aaronhyzhang/lasertrackinggimbal-ece445/vision/measurements/mpstesting.csv

frame_index | elapsed_s | detected | geometry_error | ball_diameter_m | imgsz | device_requested | device_actual | capture_ms | inference_ms | display_ms | loop_ms | fps | x1_px | y1_px | x2_px | y2_px | confidence | class_id | x_m | y_m | z_m | zx_m | zy_m | range_m | pan_error_rad | tilt_error_rad | pan_error_deg | tilt_error_deg | center_u_px | center_v_px | raw_center_u_px | raw_center_v_px | width_px | height_px | clipped | depth_reliable
1 | 0.0181662505492568 | True |  | 0.24 | 640 | mps | mps | 18.165916204452515 | 976.5718337148428 | 55.96166756004095 | 1050.796415656805 | 0.951659127400949 | 514.5846557617188 | 337.39801025390625 | 783.1223754882812 | 595.7832641601562 | 0.8574280738830566 | 32 | -0.2814008678219662 | -0.03978910861701877 | 1.109698845290386 | 1.0832563269788558 | 1.1361413636019162 | 1.1455134869630776 | -0.24834813443023765 | 0.03584041786213636 | -14.229299952800226 | 2.053504679485702 | 647.8540209984113 | 466.75158611769336 | 648.853515625 | 466.59063720703125 | 271.75853704990226 | 259.2666488310017 | False | True
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
