aaronhyzhang/lasertrackinggimbal-ece445/vision/calibration/charuco_board.png

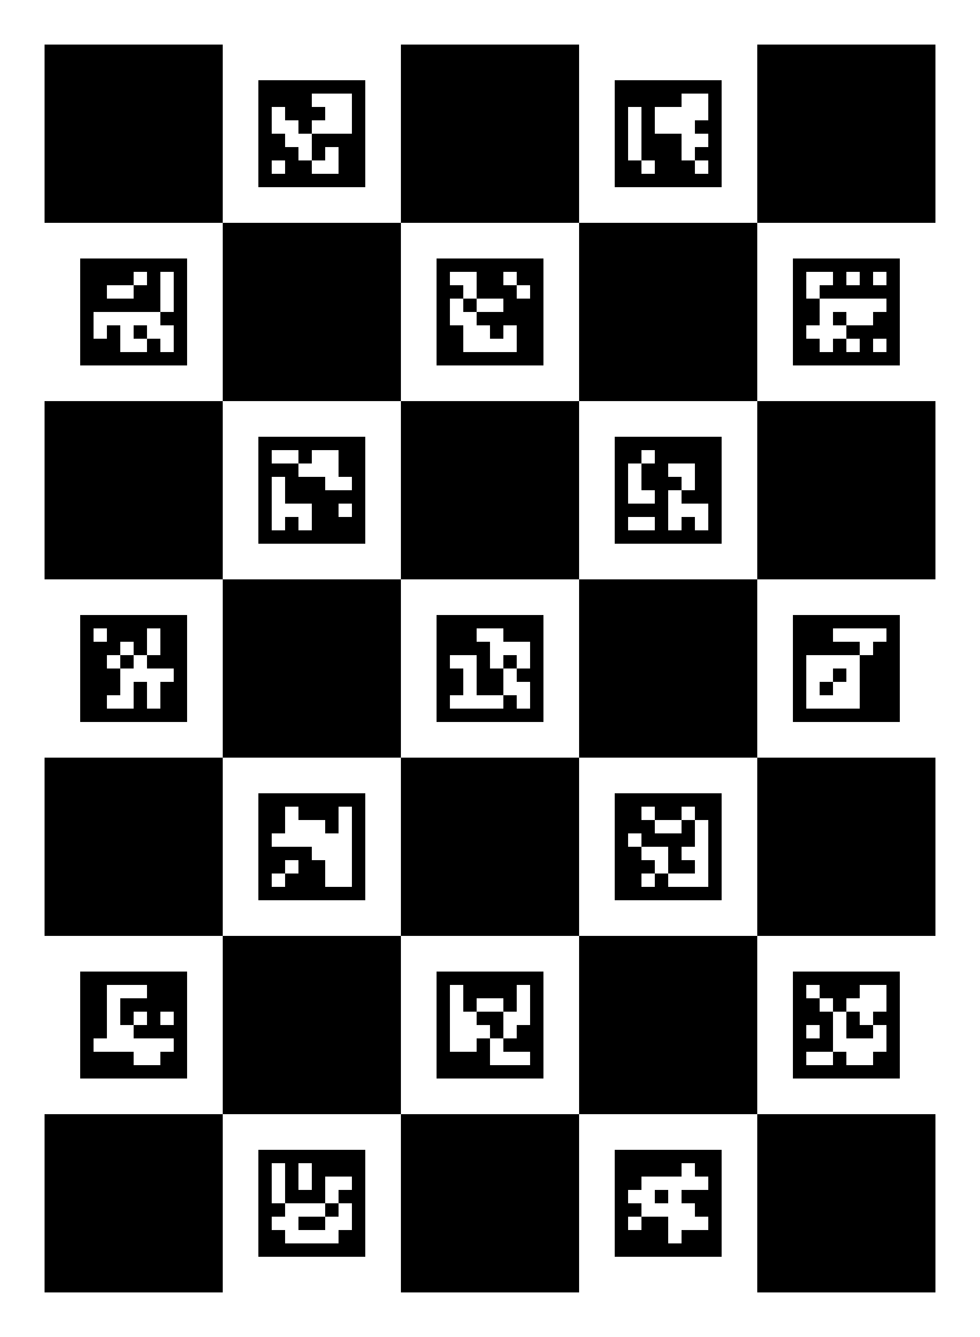
vision/calibration/charuco_board.png
