aaronhyzhang/lasertrackinggimbal-ece445/Senior_Design_PCB_CONTROL/Core/Inc/motor_profiles.h

#ifndef MOTOR_PROFILES_H
#define MOTOR_PROFILES_H
#include "pcb_config.h"

/* J3 / axis 0 / TIM1 / I2C1: tilt. User's accepted full-sweep settings,
 * 2026-10-27. These are reset defaults; Ethernet SET remains RAM-only. */
#define TILT_VELOCITY_KP_V 0.215f
#define TILT_VELOCITY_KI_V 18.795f
#define TILT_POSITION_KP 5.5f
#define TILT_MAX_RPM 110.0f
#define TILT_ACCEL_RPM_S 150.0f
#define TILT_CAL_VOLTS 1.0f
#define TILT_RUN_VOLTS 6.0f
#define TILT_ENCODER_POSITIVE_SIGN 0 /* Preserve electrical-calibration direction. */
#define TILT_COMMAND_MIN_DEG 2.0f
#define TILT_COMMAND_MAX_DEG 358.0f
#define TILT_ACCEPT_MAX_DEG 360.0f
#define TILT_TRAVEL_MAX_DEG 360.0f

/* J4 pan: accepted 15..320-degree sweep checkpoint, 2026-10-27. */
#define PAN_VELOCITY_KP_V 0.43f
#define PAN_VELOCITY_KI_V 42.3f
#define PAN_POSITION_KP 5.0f
#define PAN_MAX_RPM 110.0f
#define PAN_ACCEL_RPM_S 199.502f
#define PAN_CAL_VOLTS 2.0f
#define PAN_RUN_VOLTS 6.0f
/* Measured manually: CW raw/unwrapped 319.5, CCW raw 339.7/unwrapped -20.2.
 * Approximately 339.7..339.8 degrees free travel; CCW decreases raw angle. */
#define PAN_ENCODER_POSITIVE_SIGN (-1)
#define PAN_COMMAND_MIN_DEG 2.0f
#define PAN_COMMAND_MAX_DEG 337.0f
#define PAN_ACCEPT_MAX_DEG 337.0f
#define PAN_TRAVEL_MAX_DEG 339.8f

/* Trial: select once per target, not from shrinking distance-to-go.
 * Tilt keeps its existing trajectory. 0 threshold disables this policy. */
#define PAN_SMALL_MOVE_DEG 20.0f
#define PAN_SMALL_ACCEL_RPM_S 114.066f
#if PCB_TEST_AXIS == 0
#define CONTROL_SMALL_MOVE_DEG 0.0f
#define CONTROL_SMALL_ACCEL_RPM_S TILT_ACCEL_RPM_S
#define CONTROL_MAX_RPM TILT_MAX_RPM
#define CONTROL_ACCEL_RPM_S TILT_ACCEL_RPM_S
#define CONTROL_RUN_VOLTS TILT_RUN_VOLTS
#define CONTROL_VELOCITY_KP_V TILT_VELOCITY_KP_V
#define CONTROL_VELOCITY_KI_V TILT_VELOCITY_KI_V
#define CONTROL_POSITION_KP TILT_POSITION_KP
#define CONTROL_ENCODER_POSITIVE_SIGN TILT_ENCODER_POSITIVE_SIGN
#define CONTROL_COMMAND_MIN_DEG TILT_COMMAND_MIN_DEG
#define CONTROL_COMMAND_MAX_DEG TILT_COMMAND_MAX_DEG
#define CONTROL_ACCEPT_MAX_DEG TILT_ACCEPT_MAX_DEG
#define CONTROL_TRAVEL_MAX_DEG TILT_TRAVEL_MAX_DEG
#else
#define CONTROL_SMALL_MOVE_DEG PAN_SMALL_MOVE_DEG
#define CONTROL_SMALL_ACCEL_RPM_S PAN_SMALL_ACCEL_RPM_S
#define CONTROL_MAX_RPM PAN_MAX_RPM
#define CONTROL_ACCEL_RPM_S PAN_ACCEL_RPM_S
#define CONTROL_RUN_VOLTS PAN_RUN_VOLTS
#define CONTROL_VELOCITY_KP_V PAN_VELOCITY_KP_V
#define CONTROL_VELOCITY_KI_V PAN_VELOCITY_KI_V
#define CONTROL_POSITION_KP PAN_POSITION_KP
#define CONTROL_ENCODER_POSITIVE_SIGN PAN_ENCODER_POSITIVE_SIGN
#define CONTROL_COMMAND_MIN_DEG PAN_COMMAND_MIN_DEG
#define CONTROL_COMMAND_MAX_DEG PAN_COMMAND_MAX_DEG
#define CONTROL_ACCEPT_MAX_DEG PAN_ACCEPT_MAX_DEG
#define CONTROL_TRAVEL_MAX_DEG PAN_TRAVEL_MAX_DEG
#endif
#endif
