aaronhyzhang/lasertrackinggimbal-ece445/(commit log)

2026-10-14 Add calibrated vision tracking pipeline and unit tests
    Include camera calibration and capture utilities, detection and position estimation, CSV logging, and timing instrumentation.
    Add 62 vision tests, performance benchmarks, measurement data, calibration artifacts, vision requirements, and gitignore. Include only the YOLO26s checkpoint and test2 image fixture.
2026-11-04 Add final PCB Control firmware
